daniel-bornhorst/GVH-ALY-PM-InteractiveCounter/Hardware/GVH_TouchPad/production/bom.csv

Designator | Footprint | Quantity | Value | LCSC Part #
J2, J5 | SMD_Pad | 2 | Conn_01x01
