daniel-bornhorst/GVH-ALY-PM-InteractiveCounter/Hardware/GVH_InteractiveCounter/DXF_SVG/GVH-ALY-03-IHW-06 Illumina Portal Threshold Bus Board Ref 20241203.dxf

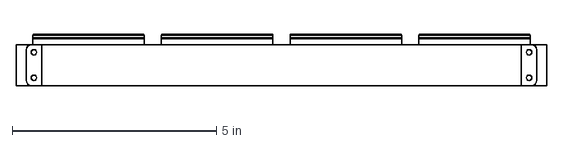
[picture p1: CAD file, 2024-12-05]
Hardware/GVH_InteractiveCounter/DXF_SVG/GVH-ALY-03-IHW-06 Illumina Portal Threshold Bus Board Ref 20241203.dxf
13.0 x 1.25 in
