daniel-bornhorst/GVH-ALY-PM-InteractiveCounter/Hardware/GVH_TouchPad/DXF_SVG/TouchOutline.dxf

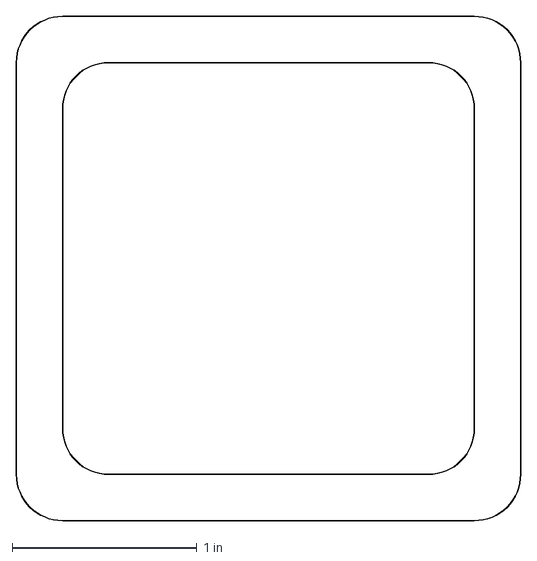
[picture p2: CAD file, 2024-12-03]
Hardware/GVH_TouchPad/DXF_SVG/TouchOutline.dxf
2.73 x 2.73 in
