daniel-bornhorst/GVH-ALY-PM-InteractiveCounter/Hardware/GVH_InteractiveCounter/DXF_SVG/GVH-ALY-03-IHW-06 Illumina Portal Threshold Bus Board Outline 20241203.dxf

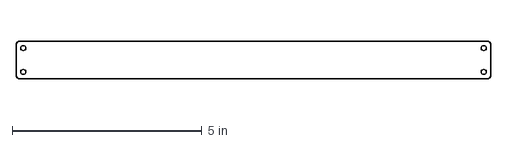
[picture p3: CAD file, 2024-12-05]
Hardware/GVH_InteractiveCounter/DXF_SVG/GVH-ALY-03-IHW-06 Illumina Portal Threshold Bus Board Outline 20241203.dxf
12.5 x 1.00 in
