daniel-bornhorst/GVH-ALY-PM-InteractiveCounter/Hardware/GVH_TouchPad/DXF_SVG/Prime Materia Cut File Illumina Portal Threshold Touch Pad 20241127.dxf

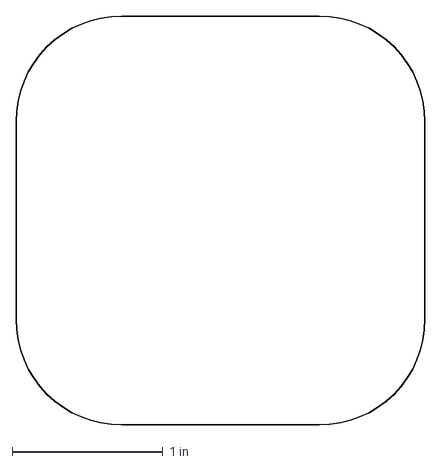
[picture p4: CAD file, 2024-12-03]
Hardware/GVH_TouchPad/DXF_SVG/Prime Materia Cut File Illumina Portal Threshold Touch Pad 20241127.dxf
2.71 x 2.71 in
