daniel-bornhorst/GVH-ALY-PM-InteractiveCounter/Hardware/GVH_TouchPad/DXF_SVG/Prime Materia Cut File Illumina Portal Threshold Ground Plane 20241127.dxf

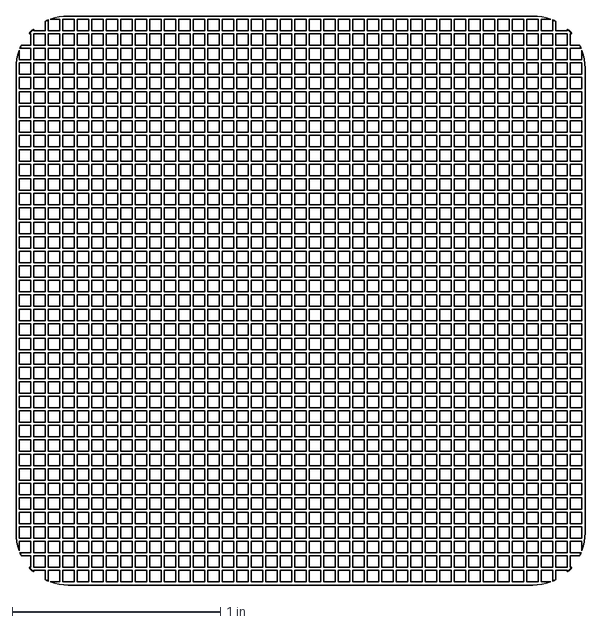
[picture p7: CAD file, 2024-12-03]
Hardware/GVH_TouchPad/DXF_SVG/Prime Materia Cut File Illumina Portal Threshold Ground Plane 20241127.dxf
2.73 x 2.73 in
