daniel-bornhorst/GVH-ALY-PM-InteractiveCounter/Hardware/GVH_CounterController/Documentation/GVH_CounterContoller__v1.0_FABRICATION.pdf

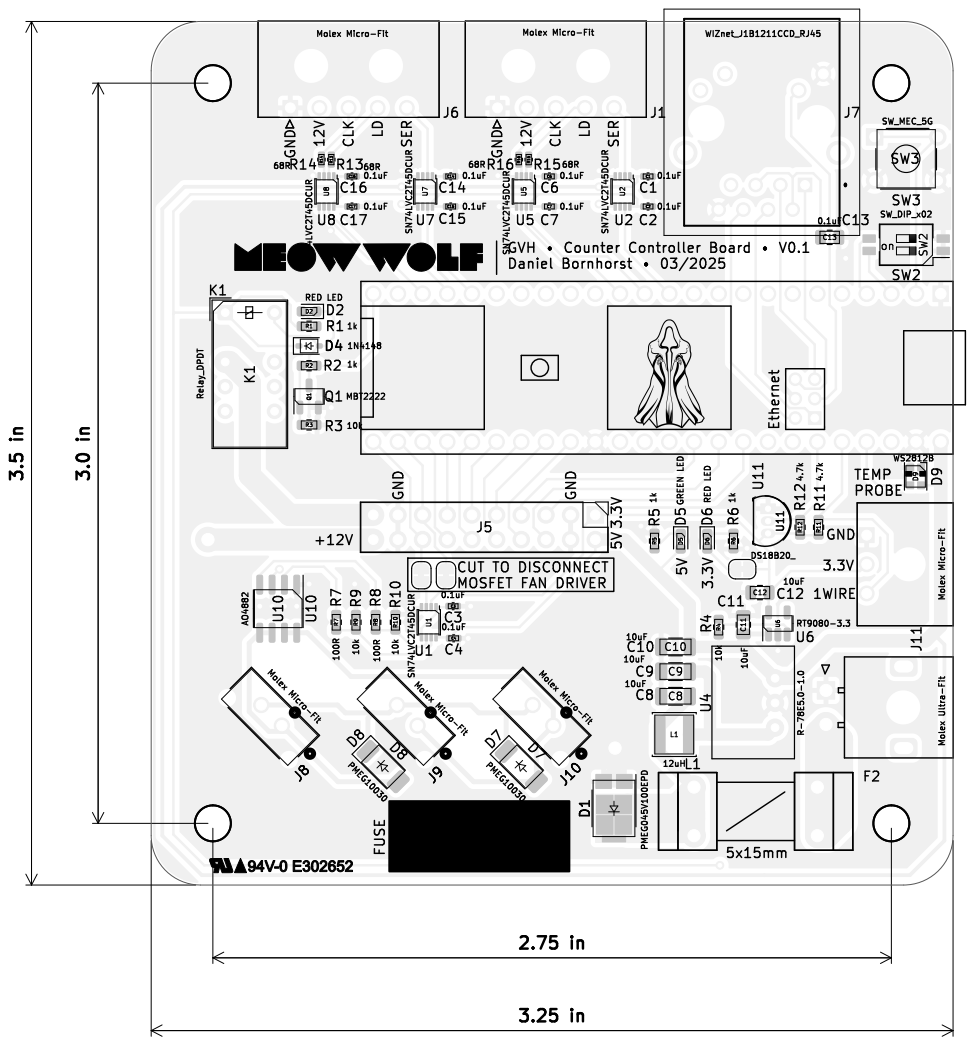
[picture p8: page 1]

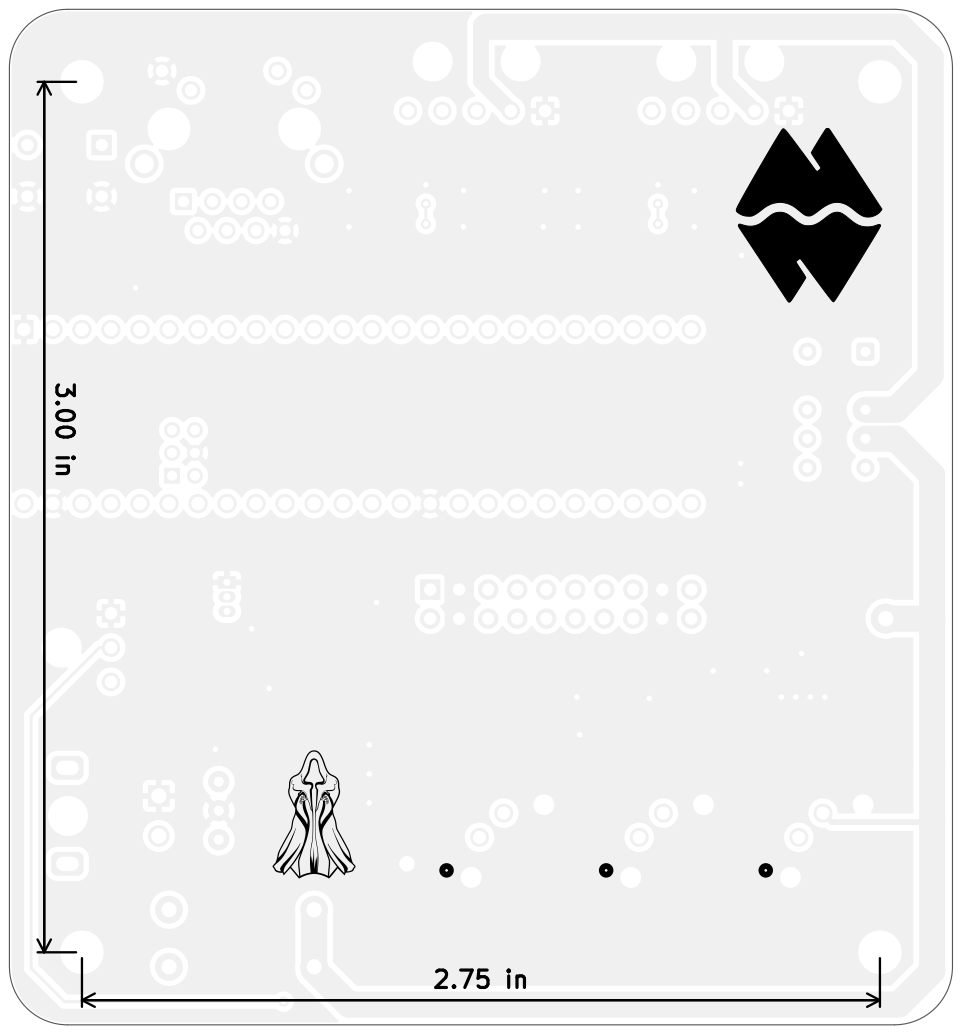
[picture p9: page 2]
D Date: 2025-03-01 KiCad; kicad; 7.0.9 Size: A4; Rev: 1.0; Id: 1/1 Title: Interactice; Counter Controller File: GVH_CounterContoller.kicad_pcb Sheet: Black; And; White; BOT Meow Wolf Daniel; Bornhorst Board2Pdf:; Black; BOT -; Page 2/2
