daniel-bornhorst/GVH-ALY-PM-InteractiveCounter/Hardware/GVH_CounterController/Documentation/GVH_CounterContoller__v1.0_FAB.pdf

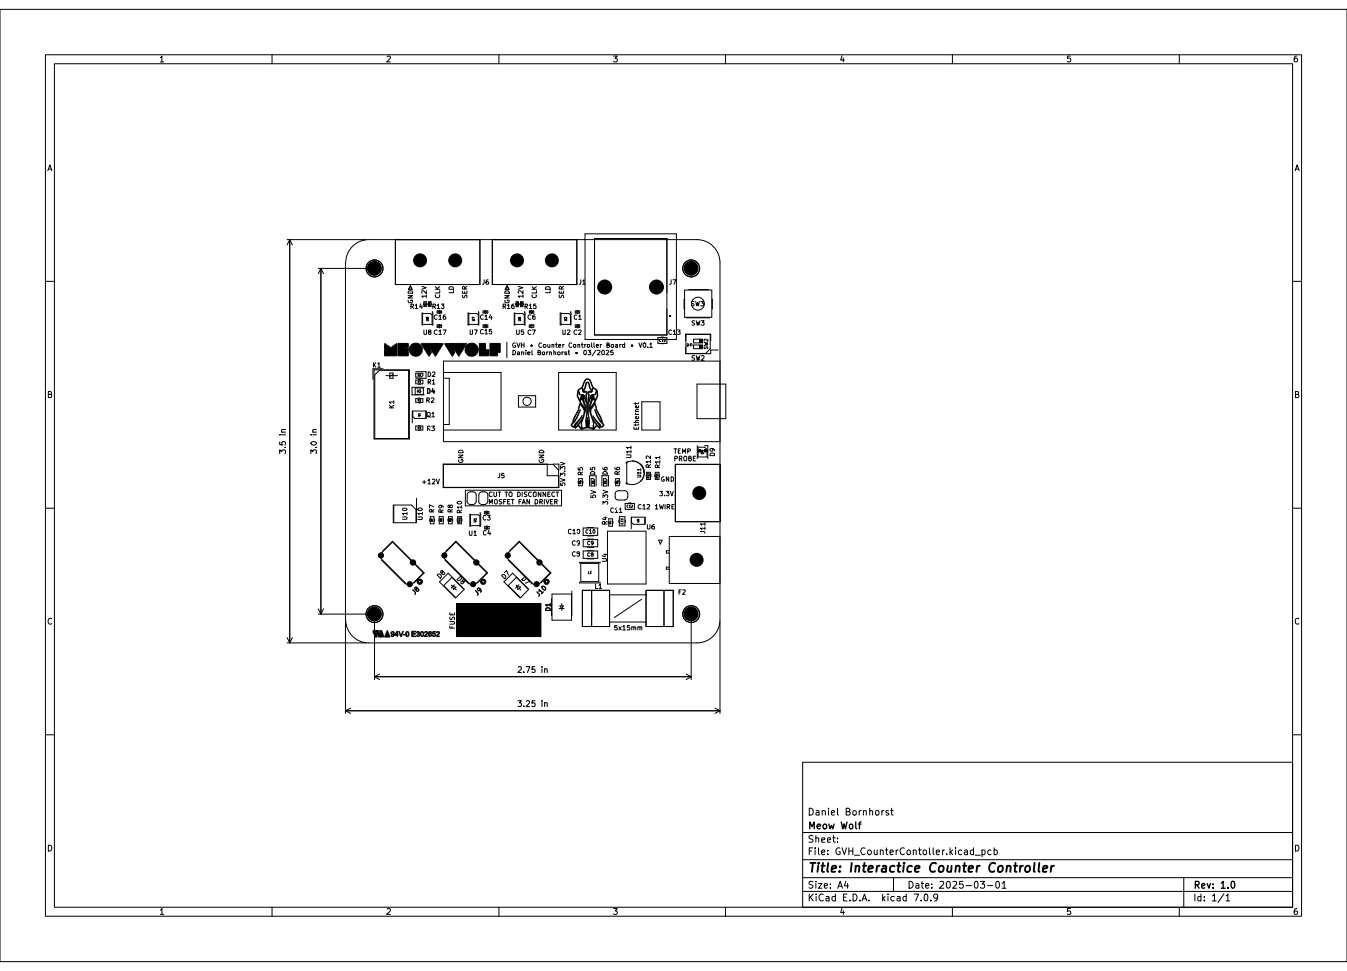
[picture p10: page 1]
