daniel-bornhorst/GVH-ALY-PM-InteractiveCounter/Hardware/GVH_CounterController/Documentation/GVH_CounterContoller__v1.0_SCHEMATIC.pdf

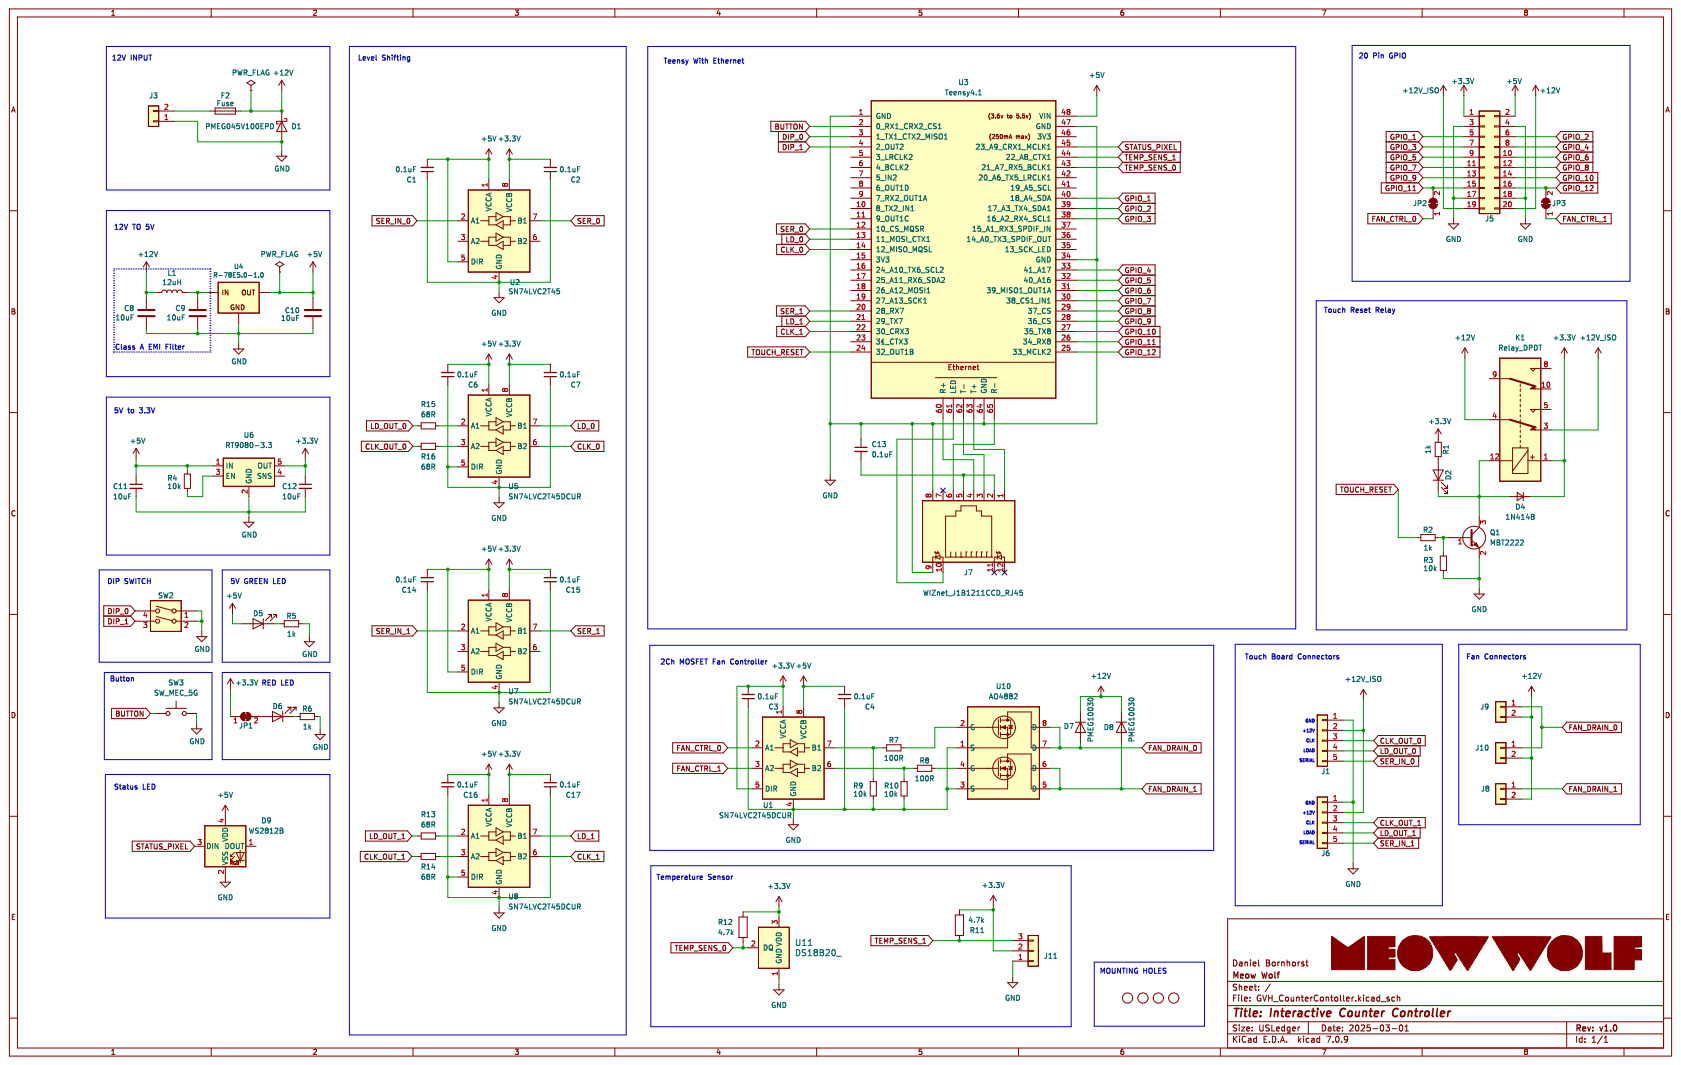
[picture p11: page 1]
