daniel-bornhorst/GVH-ALY-PM-InteractiveCounter/Hardware/GVH_CounterController/GVH_CounterContoller.kicad_pcb

## KiCad design Hardware/GVH_CounterController/GVH_CounterContoller.kicad_pcb (2025-03-07)

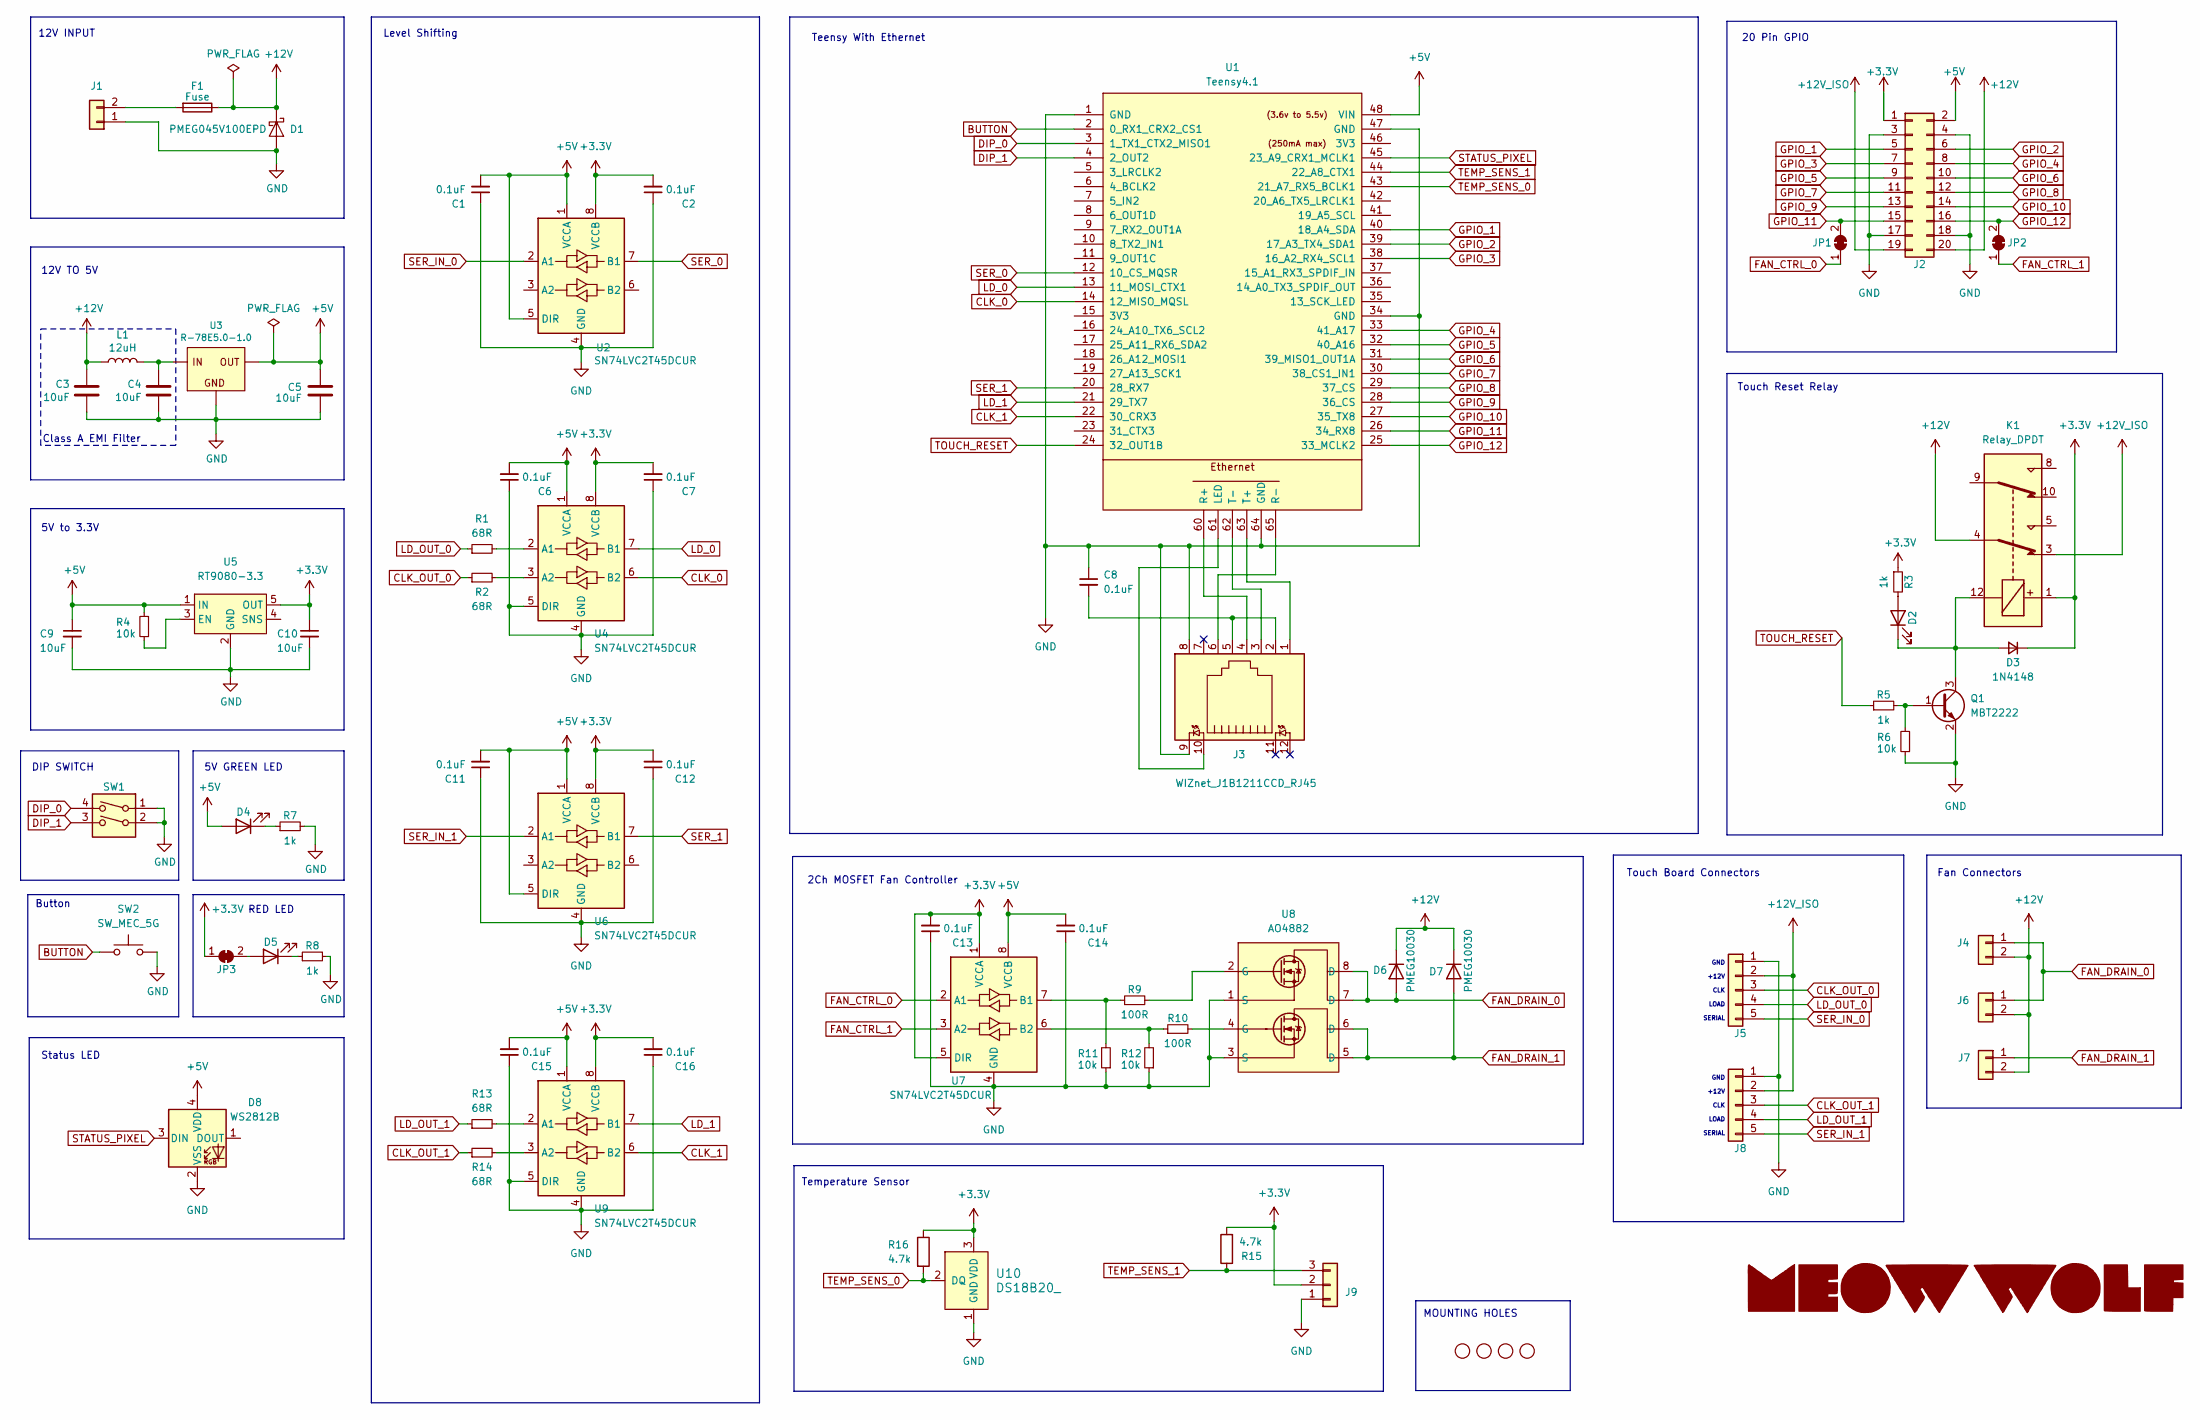
[picture p12: schematic GVH_CounterContoller.kicad_sch, Interactive Counter Controller]

Parts:
C1, C2, C6, C7, C11, C12, C13, C14, C15, C16: 0.1uF; C_0402_1005Metric; LCSC C1525
C3, C4, C5: 10uF; C_1206_3216Metric; Digikey P/N 1276-6767-1-ND
C8: 0.1uF; C_0805_2012Metric; LCSC C1711
C9, C10: 10uF; C_0805_2012Metric; LCSC C15850
D1: PMEG045V100EPD; Nexperia_CFP15_SOT-1289; LCSC C5183016
D2, D5: RED LED; LED_0603_1608Metric; Digikey P/N LTST-C190KRKT
D3: 1N4148; D_SOD-323; Digikey P/N 1N4148WS-FDICT-ND
D4: GREEN LED; LED_0603_1608Metric; Digikey P/N 160-1888-1-ND
D6, D7: PMEG10030; D_SOD-128; LCSC C5260346
D8: WS2812B; LED_WS2812B-2020_PLCC4_2.0x2.0mm; LCSC C965555
F1: Fuse; Fuseholder_2AG_5x15mm_Littelfuse_01110501Z; Digikey P/N F4189-ND
H1, H2, H3, H4: STAND-OFF
J1: Molex Ultra-Fit; MOLEX_ULTRAFIT-RA-2POS_1723104102; Digikey P/N 900-1723104102-ND
J2: Vertical Header Pins; PinHeader_2x10_P2.54mm_Vertical; Digikey P/N 2057-PH2-20-UA-ND
J3: WIZnet_J1B1211CCD_RJ45; Digikey P/N 1278-1052-ND
J4, J6, J7: Molex Micro-Fit; MOLEX_MICROFIT-VERT-2POS_436500215; Digikey P/N WM1917-ND
J5, J8: Molex Micro-Fit; MOLEX_MICROFIT-RA-5POS_436500500; Digikey P/N WM1863-ND
J9: Molex Micro-Fit; MOLEX_MICROFIT-RA-3POS_436500300; Digikey P/N WM1918-ND
JP1, JP2, JP3: SolderJumper_2_Bridged; SolderJumper-2_P1.3mm_Bridged_RoundedPad1.0x1.5mm
K1: Relay_DPDT; Relay_DPDT_Kemet_EC2; Digikey P/N 399-11042-5-ND
L1: 12uH; L_Changjiang_FNR4030S; LCSC C167880
LOGO1: MeowWolf_Logo_Horizontal
Q1: MBT2222; SOT-23-3; LCSC C82460
R1, R2, R13, R14: 68R; R_0402_1005Metric; LCSC C25131
R3, R5, R7, R8: 1k; R_0603_1608Metric; Digikey P/N 311-1.00KHRCT-ND
R4, R6, R11, R12: 10k; R_0603_1608Metric; LCSC C98220
R9, R10: 100R; R_0603_1608Metric; Digikey P/N 311-100HRCT-ND
R15, R16: 4.7k; R_0603_1608Metric; LCSC C99782
SW1: SW_DIP_x02; SW_DIP_SPSTx02_Slide_KingTek_DSHP02TS_W7.62mm_P1.27mm; LCSC C7462922
SW2: SW_MEC_5G; SW_TH_Tactile_Omron_B3F-10xx; Digikey P/N SW402-ND
U1: Teensy4.1; Teensy41_ethernet_only; Digikey P/N 1568-DEV-16996-ND
U2, U4, U6, U7, U9: SN74LVC2T45DCUR; VSSOP-8_2.4x2.1mm_P0.5mm; Digikey P/N 296-32331-1-ND
U3: R-78E5.0-1.0; DC-DC_CONVERTER_R-78E5; Digikey P/N 945-2201-ND
U5: RT9080-3.3; SOT-23-5; LCSC C841192
U8: AO4882; SOIC-8_3.9x4.9mm_P1.27mm; Digikey P/N 785-1317-1-ND
U10: DS18B20_; TO-92-3; Digikey P/N DS18B20+-ND

Connections:
+3.3V: C2.2, C7.2, C10.1, C12.2, C13.2, C16.2, D3.1 (K), J2.1, J9.2, JP3.1 (A), K1.1, R3.1, R15.2, R16.1, U2.8 (VCCB), U4.8 (VCCB), U5.5 (OUT), U6.8 (VCCB), U7.1 (VCCA), U7.5 (DIR), U9.8 (VCCB), U10.3 (VDD)
+5V: C1.2, C5.1, C6.2, C9.1, C11.2, C14.2, C15.2, D4.2 (A), D8.4 (VDD), J2.2, R4.2, U1.48 (VIN), U2.1 (VCCA), U2.5 (DIR), U3.VOUT (OUT), U4.1 (VCCA), U5.1 (IN), U6.1 (VCCA), U6.5 (DIR), U7.8 (VCCB), U9.1 (VCCA)
+12V: C3.1, D1.3 (K), D6.1 (K), D7.1 (K), F1.1, J2.20, J4.2, J6.2, J7.2, K1.4, L1.1
+12V_ISO: J2.19, J5.2, J8.2, K1.3
BUTTON: SW2.1 (A), U1.2 (0_RX1_CRX2_CS1)
CLK_0: U1.14 (12_MISO_MQSL), U4.6 (B2)
CLK_1: U1.22 (30_CRX3), U9.6 (B2)
CLK_OUT_0: J5.3, R2.1
CLK_OUT_1: J8.3, R14.1
DIP_0: SW1.4, U1.3 (1_TX1_CTX2_MISO1)
DIP_1: SW1.3, U1.4 (2_OUT2)
FAN_CTRL_0: JP1.1 (A), U7.2 (A1)
FAN_CTRL_1: JP2.1 (A), U7.3 (A2)
FAN_DRAIN_0: D6.2 (A), J4.1, J6.1, U8.7 (D), U8.8 (D)
FAN_DRAIN_1: D7.2 (A), J7.1, U8.5 (D), U8.6 (D)
GND: C1.1, C2.1, C3.2, C4.2, C5.2, C6.1, C7.1, C8.1, C9.2, C10.2, C11.1, C12.1, C13.1, C14.1, C15.1, C16.1, D1.1 (A), D1.2 (A), D8.2 (VSS), J1.1, J2.3, J2.4, J2.17, J2.18, J3.8, J3.9, J5.1, J8.1, J9.1, Q1.2 (E), R6.1, R7.2, R8.2, R11.1, R12.1, SW1.1, SW1.2, SW2.2 (B), U1.1 (GND), U1.34 (GND), U1.47 (GND), U1.64 (GND), U2.4 (GND), U3.GND, U4.4 (GND), U4.5 (DIR), U5.2 (GND), U6.4 (GND), U7.4 (GND), U8.1 (S), U8.3 (S), U9.4 (GND), U9.5 (DIR), U10.1 (GND)
GPIO_1: J2.5, U1.40 (18_A4_SDA)
GPIO_2: J2.6, U1.39 (17_A3_TX4_SDA1)
GPIO_3: J2.7, U1.38 (16_A2_RX4_SCL1)
GPIO_4: J2.8, U1.33 (41_A17)
GPIO_5: J2.9, U1.32 (40_A16)
GPIO_6: J2.10, U1.31 (39_MISO1_OUT1A)
GPIO_7: J2.11, U1.30 (38_CS1_IN1)
GPIO_8: J2.12, U1.29 (37_CS)
GPIO_9: J2.13, U1.28 (36_CS)
GPIO_10: J2.14, U1.27 (35_TX8)
GPIO_11: J2.15, JP1.2 (B), U1.26 (34_RX8)
GPIO_12: J2.16, JP2.2 (B), U1.25 (33_MCLK2)
LD_0: U1.13 (11_MOSI_CTX1), U4.7 (B1)
LD_1: U1.21 (29_TX7), U9.7 (B1)
LD_OUT_0: J5.4, R1.1
LD_OUT_1: J8.4, R13.1
unnamed: C8.2, J3.2, J3.5
unnamed: D2.2 (A), R3.2
unnamed: D2.1 (K), D3.2 (A), K1.12, Q1.3 (C)
unnamed: D4.1 (K), R7.1
unnamed: D5.2 (A), JP3.2 (B)
unnamed: D5.1 (K), R8.1
unnamed: F1.2, J1.2
unnamed: Q1.1 (B), R5.2, R6.2
unnamed: R9.2, U8.2 (G)
unnamed: R10.2, U8.4 (G)
unnamed: J3.10, U1.61 (LED)
unnamed: J3.4, U1.60 (R+)
unnamed: J3.6, U1.65 (R-)
unnamed: J3.1, U1.63 (T+)
unnamed: J3.3, U1.62 (T-)
unnamed: C4.1, L1.2, U3.VIN (IN)
unnamed: R1.2, U4.2 (A1)
unnamed: R2.2, U4.3 (A2)
unnamed: R4.1, U5.3 (EN)
unnamed: R9.1, R11.2, U7.7 (B1)
unnamed: R10.1, R12.2, U7.6 (B2)
unnamed: R13.2, U9.2 (A1)
unnamed: R14.2, U9.3 (A2)
SER_0: U1.12 (10_CS_MQSR), U2.7 (B1)
SER_1: U1.20 (28_RX7), U6.7 (B1)
SER_IN_0: J5.5, U2.2 (A1)
SER_IN_1: J8.5, U6.2 (A1)
STATUS_PIXEL: D8.3 (DIN), U1.45 (23_A9_CRX1_MCLK1)
TEMP_SENS_0: R16.2, U1.43 (21_A7_RX5_BCLK1), U10.2 (DQ)
TEMP_SENS_1: J9.3, R15.1, U1.44 (22_A8_CTX1)
TOUCH_RESET: R5.1, U1.24 (32_OUT1B)

Notes on the sheet:
5V to 3.3V
Temperature Sensor
GND +12V CLK LOAD SERIAL
5V GREEN LED
12V INPUT
Teensy With Ethernet
MOUNTING HOLES
Button
DIP SWITCH
Touch Reset Relay
2Ch MOSFET Fan Controller
Level Shifting
Fan Connectors
20 Pin GPIO
Touch Board Connectors
Class A EMI Filter
Status LED
12V TO 5V
RED LED

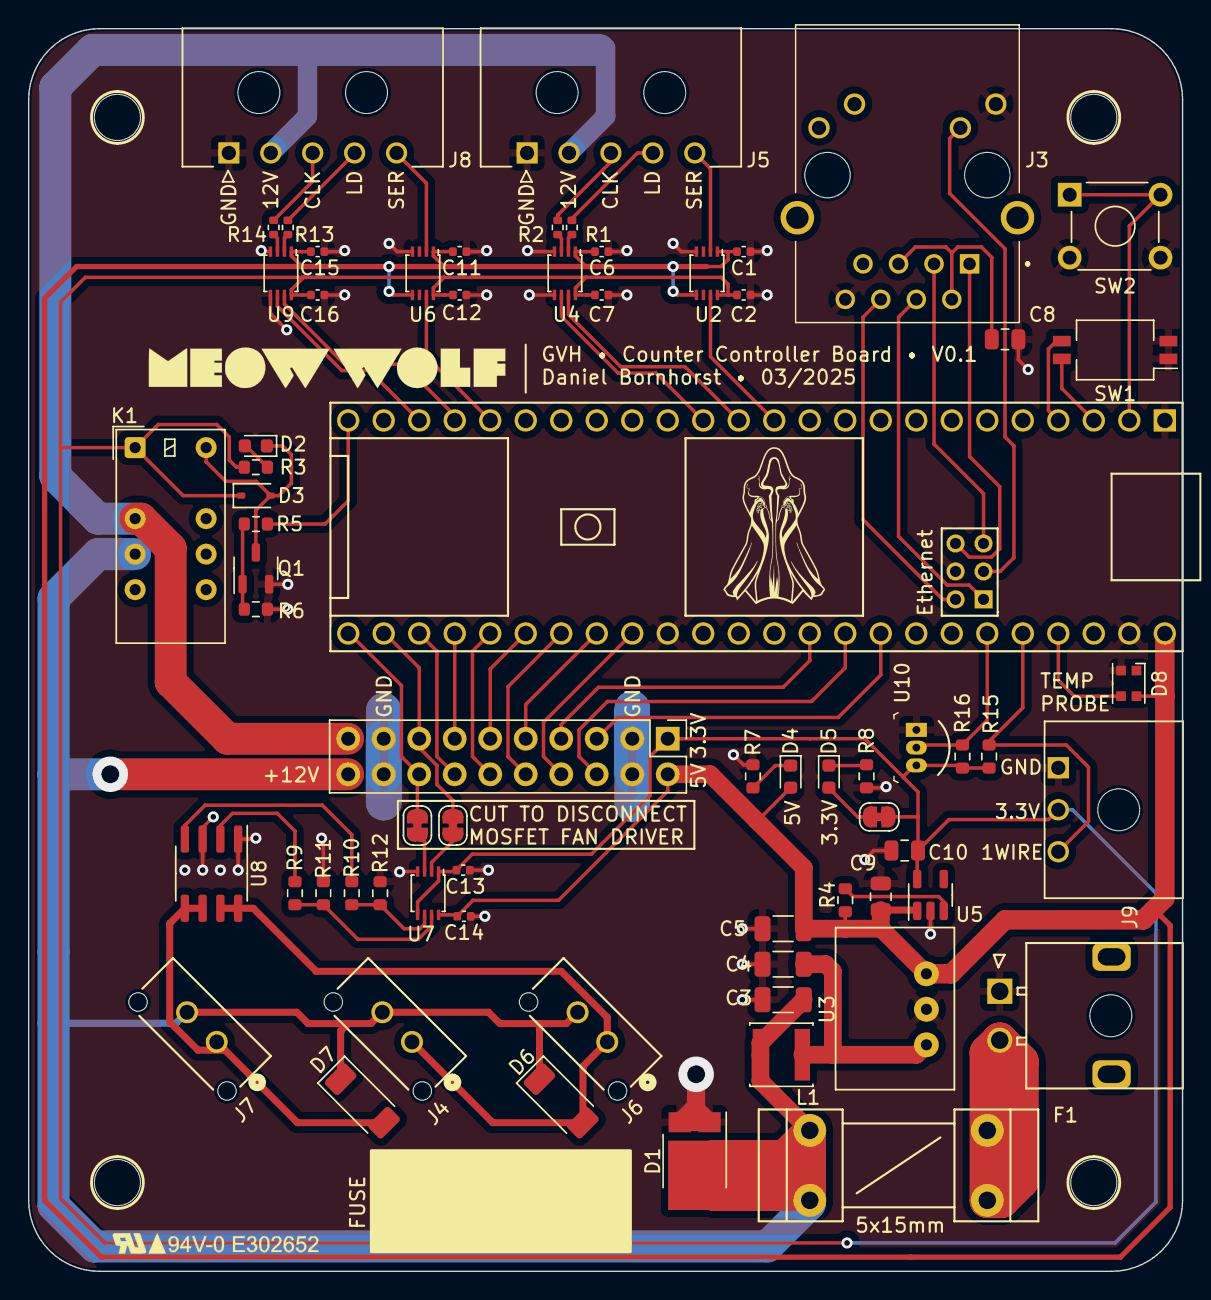
[picture p13: board GVH_CounterContoller.kicad_pcb from above]

Board: 2 copper layers, 82.5 x 88.9 mm, 72 parts (0 on the bottom side), 63 nets.
