daniel-bornhorst/GVH-ALY-PM-InteractiveCounter/Hardware/GVH_CounterController_take1/CounterContoller_take1.kicad_pcb

## KiCad design Hardware/GVH_CounterController_take1/CounterContoller_take1.kicad_pcb (2024-12-28)

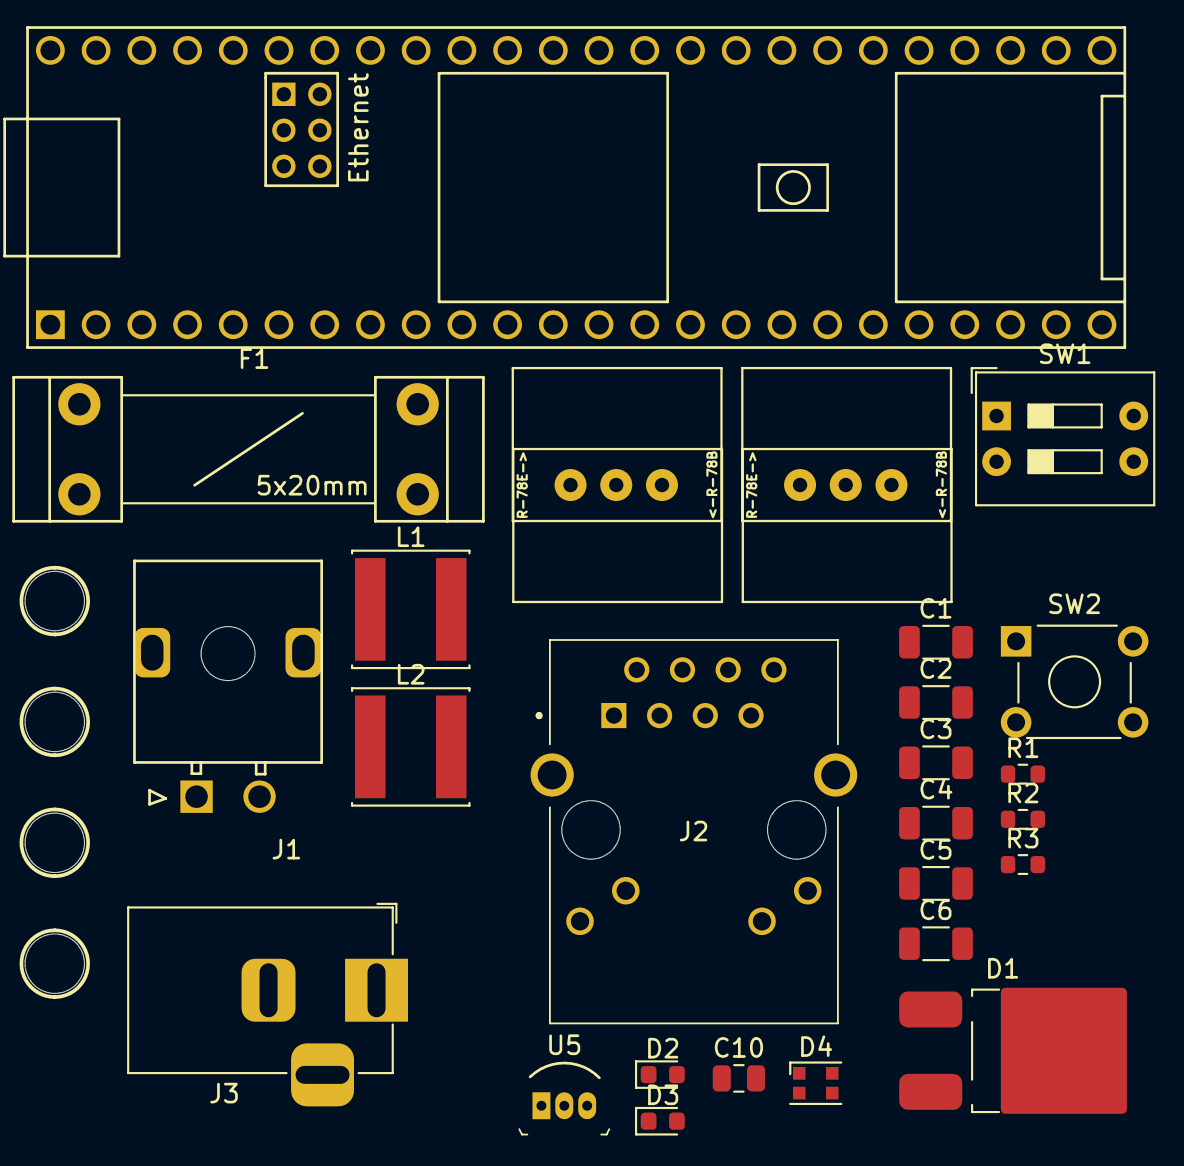
[picture p14: board CounterContoller_take1.kicad_pcb from above]

Board: 2 copper layers, 30 parts (0 on the bottom side), 17 nets, no tracks yet.

Parts:
C1, C3, C4, C6: 10uF; C_1206_3216Metric
C2, C5: 4.7uF; C_1206_3216Metric
C10: 0.1uF; C_0805_2012Metric
D1: Reverse Protection Diode; TO-252-2_TabPin1
D2: GREEN LED; LED_0603_1608Metric
D3: RED LED; LED_0603_1608Metric
D4: WS2812B; LED_WS2812B-2020_PLCC4_2.0x2.0mm
F1: Fuse; Fuseholder_5x20mm_Littelfuse_01110501Z
H1, H2, H3, H4: STAND-OFF
J1: Molex Ultra-Fit; MOLEX_ULTRAFIT-RA-2POS_1723104102
J2: WIZnet_J1B1211CCD_RJ45
J3: Barrel jack; BarrelJack_Horizontal
L1, L2: 10uH; L_Changjiang_FNR6045S
R1: 560; R_0603_1608Metric
R2: 220; R_0603_1608Metric
R3: 4.7k; R_0603_1608Metric
SW1: SW_DIP_x02; SW_DIP_SPSTx02_Slide_9.78x7.26mm_W7.62mm_P2.54mm
SW2: SW_MEC_5G; SW_TH_Tactile_Omron_B3F-10xx
U1: R-78B5.0-2.0; DC-DC_CONVERTER_R-78E_R-78B
U2: Teensy4.1; Teensy41_ethernet_only
U3: R-78B3.3-2.0; DC-DC_CONVERTER_R-78E_R-78B
U5: DS18B20_; TO-92-3

Connections:
+3.3V: C6.1, D3.2 (A), R3.1, U3.VOUT (OUT), U5.3 (VDD)
+5V: C3.1, D2.2 (A), D4.4 (VDD), U1.VOUT (OUT), U2.48 (VIN)
+12V: C1.1, C4.1, D1.1 (K), F1.1, L1.1, L2.1
BUTTON: SW2.1 (A), SW2.2 (A)
GND: C1.2, C2.2, C3.2, C4.2, C5.2, C6.2, C10.2, D1.2 (A), D4.2 (VSS), J1.1, J2.8, J2.9, J3.2, J3.3, R1.2, R2.2, SW1.1, SW1.2, U1.GND, U2.1 (GND), U2.34 (GND), U2.47 (GND), U2.64 (GND), U3.GND, U5.1 (GND)
unnamed: C10.1, J2.2, J2.5
unnamed: D2.1 (K), R1.1
unnamed: D3.1 (K), R2.1
unnamed: F1.2, J1.2, J3.1
unnamed: C2.1, L1.2, U1.VIN (IN)
unnamed: J2.10, U2.61 (LED)
unnamed: J2.4, U2.60 (R+)
unnamed: J2.6, U2.65 (R-)
unnamed: J2.1, U2.63 (T+)
unnamed: J2.3, U2.62 (T-)
unnamed: C5.1, L2.2, U3.VIN (IN)
TEMP_SENS1: R3.2, U5.2 (DQ)
