daniel-bornhorst/GVH-ALY-PM-InteractiveCounter/Hardware/GVH_InteractiveCounter/GVH_InteractiveCounter.kicad_pcb

## KiCad design Hardware/GVH_InteractiveCounter/GVH_InteractiveCounter.kicad_pcb (2024-12-07)

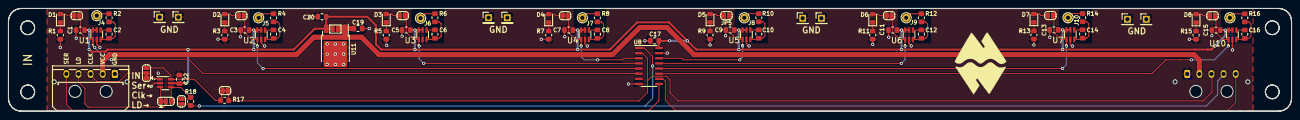
[picture p15: board GVH_InteractiveCounter.kicad_pcb from above]

Board: 2 copper layers, 317.5 x 25.4 mm, 88 parts (1 on the bottom side), 61 nets.

Parts:
C1, C3, C5, C7, C9, C11, C13, C15, C17, C20, C22: 0.1uF; C_0805_2012Metric_Pad1.18x1.45mm_HandSolder
C2, C4, C6, C8, C10, C12, C14, C16: 22nF; C_0805_2012Metric_Pad1.18x1.45mm_HandSolder
C19: 0.33uF; C_0805_2012Metric_Pad1.18x1.45mm_HandSolder
D1, D2, D3, D4, D5, D6, D7, D8: Touch_Indicator; LED_0805_2012Metric_Pad1.15x1.40mm_HandSolder
J1, J2: Molex Micro-Fit; Molex_Micro-Fit_3.0_1x05_Horizontal_Vertical_Combo
J4, J5, J6, J7, J8, J9, J10, J11: Electrode; Pin_D1.0mm_L10.0mm
J12, J13, J14, J15, J16, J17, J18, J19: Conn_01x01; PinHeader_1x01_P2.54mm_Vertical
JP1, JP2, JP3, JP4, JP5, JP6, JP7, JP8: SolderJumper_2_Bridged; SolderJumper-2_P1.3mm_Open_RoundedPad1.0x1.5mm
JP11: SolderJumper_2_Open; SolderJumper-2_P1.3mm_Open_Pad1.0x1.5mm
JP14, JP15: SolderJumper_3_Bridged12; SolderJumper-3_P1.3mm_Bridged12_RoundedPad1.0x1.5mm
JP16, JP17: SolderJumper_2_Open; SolderJumper-2_P1.3mm_Open_RoundedPad1.0x1.5mm
R1, R3, R5, R7, R9, R11, R13, R15: 150R; R_0805_2012Metric_Pad1.20x1.40mm_HandSolder
R2, R4, R6, R8, R10, R12, R14, R16: 10K; R_0805_2012Metric_Pad1.20x1.40mm_HandSolder
R17, R18: 100; R_0805_2012Metric_Pad1.20x1.40mm_HandSolder
U1, U2, U3, U4, U5, U6, U7, U10: AT42QT1010; AT42QT1010-TSGR_1
U8: SN74HC165DR; SOP-16_3.9x9.9mm_P1.27mm
U11: L7805; TO-252-2
U13: SN74LVC2G17; SOT-23-6_Handsoldering

Connections:
+5V: C1.1, C3.1, C5.1, C7.1, C9.1, C11.1, C13.1, C15.1, C17.1, C20.1, C22.1, JP11.2 (B), U1.5 (VDD), U1.6 (SYNC), U2.5 (VDD), U2.6 (SYNC), U3.5 (VDD), U3.6 (SYNC), U4.5 (VDD), U4.6 (SYNC), U5.5 (VDD), U5.6 (SYNC), U6.5 (VDD), U6.6 (SYNC), U7.5 (VDD), U7.6 (SYNC), U8.16 (VCC), U10.5 (VDD), U10.6 (SYNC), U11.3 (OUT), U13.5 (VCC)
/Touch Sensor 1/TOUCH_PAD: J4.1, R2.1
/Touch Sensor 2/TOUCH_PAD: J5.1, R4.1
/Touch Sensor 3/TOUCH_PAD: J6.1, R6.1
/Touch Sensor 4/TOUCH_PAD: J7.1, R8.1
/Touch Sensor 5/TOUCH_PAD: J8.1, R10.1
/Touch Sensor 6/TOUCH_PAD: J9.1, R12.1
/Touch Sensor 7/TOUCH_PAD: J10.1, R14.1
/Touch Sensor 8/TOUCH_PAD: J11.1, R16.1
CLK: J1.3, JP14.2 (C)
CLK_OUT: J2.3, JP16.2 (B), R17.1, U8.2 (CLK)
GND: C1.2, C3.2, C5.2, C7.2, C9.2, C11.2, C13.2, C15.2, C17.2, C19.2, C20.2, C22.2, J1.1, J2.1, J12.1, J13.1, J14.1, J15.1, J16.1, J17.1, J18.1, J19.1, R1.1, R3.1, R5.1, R7.1, R9.1, R11.1, R13.1, R15.1, U1.2 (VSS), U2.2 (VSS), U3.2 (VSS), U4.2 (VSS), U5.2 (VSS), U6.2 (VSS), U7.2 (VSS), U8.8 (GND), U8.15 (~CE), U10.2 (VSS), U11.2 (GND), U13.2 (GND)
LOAD_OUT: J2.4, JP17.2 (B), R18.1, U8.1 (~LD)
unnamed: D1.2 (A), JP1.2 (B)
unnamed: D1.1 (K), R1.2
unnamed: D2.2 (A), JP2.2 (B)
unnamed: D2.1 (K), R3.2
unnamed: D3.2 (A), JP3.2 (B)
unnamed: D3.1 (K), R5.2
unnamed: D4.2 (A), JP4.2 (B)
unnamed: D4.1 (K), R7.2
unnamed: D5.2 (A), JP5.2 (B)
unnamed: D5.1 (K), R9.2
unnamed: D6.2 (A), JP6.2 (B)
unnamed: D6.1 (K), R11.2
unnamed: D7.2 (A), JP7.2 (B)
unnamed: D7.1 (K), R13.2
unnamed: D8.2 (A), JP8.2 (B)
unnamed: D8.1 (K), R15.2
unnamed: JP14.1 (A), U13.1 (1A)
unnamed: JP14.3 (B), JP16.1 (A), R17.2, U13.6 (1Y)
unnamed: JP15.1 (A), U13.3 (2A)
unnamed: JP15.3 (B), JP17.1 (A), R18.2, U13.4 (2Y)
unnamed: C2.2, U1.4 (SNS)
unnamed: C2.1, R2.2, U1.3 (SNSK)
unnamed: C4.2, U2.4 (SNS)
unnamed: C4.1, R4.2, U2.3 (SNSK)
unnamed: C6.2, U3.4 (SNS)
unnamed: C6.1, R6.2, U3.3 (SNSK)
unnamed: C8.2, U4.4 (SNS)
unnamed: C8.1, R8.2, U4.3 (SNSK)
unnamed: C10.2, U5.4 (SNS)
unnamed: C10.1, R10.2, U5.3 (SNSK)
unnamed: C12.2, U6.4 (SNS)
unnamed: C12.1, R12.2, U6.3 (SNSK)
unnamed: C14.2, U7.4 (SNS)
unnamed: C14.1, R14.2, U7.3 (SNSK)
unnamed: C16.2, U10.4 (SNS)
unnamed: C16.1, R16.2, U10.3 (SNSK)
SERIAL_IN: J2.5, U8.10 (SER)
SERIAL_OUT: J1.5, U8.9 (QH)
TOUCH_1: JP1.1 (A), U1.1 (OUT), U8.6 (H)
TOUCH_2: JP2.1 (A), U2.1 (OUT), U8.5 (G)
TOUCH_3: JP3.1 (A), U3.1 (OUT), U8.4 (F)
TOUCH_4: JP4.1 (A), U4.1 (OUT), U8.3 (E)
TOUCH_5: JP5.1 (A), U5.1 (OUT), U8.14 (D)
TOUCH_6: JP6.1 (A), U6.1 (OUT), U8.13 (C)
TOUCH_7: JP7.1 (A), U7.1 (OUT), U8.12 (B)
TOUCH_8: JP8.1 (A), U8.11 (A), U10.1 (OUT)
VCC: C19.1, J1.2, J2.2, JP11.1 (A), U11.1 (IN)
~LOAD: J1.4, JP15.2 (C)
