daniel-bornhorst/GVH-ALY-PM-InteractiveCounter/(commit log)

2024-10-19 All shift in working, teensy ethernet working
2024-11-15 Added PCB Parts to KiCad Project Library
    [GVH_InteractiveCounter.kicad_pcb, GVH_InteractiveCounter.kicad_sch, PCB_Template.kicad_sch]
2024-11-18 Saving before changing from 1206 to 0805 components
    [GVH_InteractiveCounter.kicad_pcb, GVH_InteractiveCounter.kicad_sch, Touch_Circuit.kicad_sch, Touch_Sensor.kicad_sch]
2024-11-21 Backing up work on PCB before some major changes
    [GVH_InteractiveCounter.kicad_pcb, GVH_InteractiveCounter.kicad_sch, Touch_Sensor.kicad_sch]
2024-12-03 Board version 2 done. Not happy will start over
    [GVH_InteractiveCounter.kicad_sch, Prime Materia Cut File Illumina Portal Threshold FR Board 20241127.dxf, Prime Materia Cut File Illumina Portal Threshold Ground Plane 20241127.dxf, Prime Materia Cut File Illumina Portal Threshold Touch Pad 20241127.dxf, TouchBoard Outline.dxf, TouchOutline.dxf, Touch_Sensor.kicad_sch]
2024-12-03 Created touch electrode board
    [BOM-GVH_TouchPad.csv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]
2024-12-05 Finished another layout. This is probably the one.
    Also finished the touch pad layouts
    [GVH-ALY-03-IHW-06 Illumina Portal Threshold Bus Board Outline 20241203.dxf, GVH-ALY-03-IHW-06 Illumina Portal Threshold Bus Board Ref 20241203.dxf, GVH_InteractiveCounter.kicad_pcb, GVH_InteractiveCounter.kicad_sch, GVH_InteractiveCounter_Layout_Pass1.kicad_pcb, GVH_InteractiveCounter_Layout_Pass2.kicad_pcb, GVH_TouchPad_Circle.kicad_pcb, GVH_TouchPad_Square.kicad_pcb]
2024-12-06 Updated all of the parts to have the LCSC part numbers
    [GVH_InteractiveCounter.kicad_sch, GVH_InteractiveCounter_Layout_Pass3.kicad_pcb, Touch_Sensor.kicad_sch, bom.csv, designators.csv, positions.csv]
2024-12-07 Layouts done and ordered.
    [GVH_InteractiveCounter.kicad_pcb, GVH_InteractiveCounter.kicad_sch, GVH_InteractiveCounter_Layout_Pass3.kicad_pcb, GVH_TouchPad_Circle.kicad_pcb, GVH_TouchPad_Square.kicad_pcb, Touch_Sensor.kicad_sch, bom.csv, designators.csv]
2024-12-18 Cleaned up some of the Kicad projects
    [GVH_TouchPadSquare.kicad_pcb, GVH_TouchPad_take1.kicad_pcb]
2024-12-19 Repo cleanup
    [GVH_InteractiveCounter_Layout_Pass1.kicad_pcb, GVH_InteractiveCounter_Layout_Pass2.kicad_pcb, GVH_InteractiveCounter_Layout_Pass3.kicad_pcb]
2024-12-28 Added counter controller PCB
    [GVH_CounterController.kicad_pcb, GVH_CounterController.kicad_sch, GVH_InteractiveCounter.kicad_sch, Input_Output.kicad_sch]
2025-01-30 Counter Controller PCB - Added IO Level Shifter Sheet, Updated from Template
    [300mm x 300mm Construction.dxf, 300mm x 300mm Edge Cut No Holes.dxf, 300mm x 300mm Edge Cut With Holes.dxf, 4.5x5 Construction.dxf, 4.5x5 Edge Cut No Holes.dxf, 4.5x5 Edge Cut With Holes.dxf, CounterContoller_take1.kicad_pcb, CounterContoller_take1.kicad_sch]
2025-02-02 Added outlines for counter controller
    [3.25x3.5 Edge Cut No Holes.dxf, 3.25x3.5 Edge Cut With Holes.dxf]
2025-02-20 Added Mosfet fan controller to CounterController Schematic
    [GVH_CounterContoller.kicad_pcb, GVH_CounterContoller.kicad_sch, IO_Level_Shift.kicad_sch]
2025-02-20 Checkpoint before rerouting the power supply
    [GVH_CounterContoller.kicad_pcb, GVH_CounterContoller.kicad_sch]
2025-02-22 Added header for two board stack design
    This will allow the fans to be connected horizontally
    [CounterContoller_take1.kicad_pcb, CounterContoller_take1.kicad_sch, GVH_CounterContoller.kicad_pcb, GVH_CounterContoller.kicad_sch, IO_Level_Shift.kicad_sch, Input_Output.kicad_sch]
2025-02-22 Checkpoint before removing fan connectors
    [GVH_CounterContoller.kicad_pcb, GVH_CounterContoller.kicad_sch, IO_Level_Shift.kicad_sch]
2025-02-26 Noticed that voltage translators wont work 3-5v, changing that part
    [GVH_CounterContoller.kicad_pcb, GVH_CounterContoller.kicad_sch]
2025-02-27 Level shifting redesign complete
    [GVH_CounterContoller.kicad_pcb, GVH_CounterContoller.kicad_sch]
2025-02-27 Added Glass fuse and cleaned up fan controller
    [GVH_CounterContoller.kicad_pcb, GVH_CounterContoller.kicad_sch]
2025-02-28 About to change gate driver buffer, it wont shift logic up
    [GVH_CounterContoller.kicad_pcb, GVH_CounterContoller.kicad_sch]
2025-03-07 Controller board finished and documentation created
    [3.25x3.5 Edge Cut No Holes.dxf, 3.25x3.5 Edge Cut With Holes.dxf, 300mm x 300mm Construction.dxf, 300mm x 300mm Edge Cut No Holes.dxf, 300mm x 300mm Edge Cut With Holes.dxf, 4.5x5 Construction.dxf, 4.5x5 Edge Cut No Holes.dxf, 4.5x5 Edge Cut With Holes.dxf]
